jacobgkhuynh-stack/D67/README.md

# Diodeless-Keyboard with 67 keys in a 65% layout
So here's what this is, a Diodeless Keyboard that uses graph theory like Triliu's JESK56 keyboard https://github.com/triliu/JESK56 but using a different graph https://houseofgraphs.org/graphs/49999.
The nodes are pins and the vertices of the graph are switches using this method and placing them in a way can make it so that practically when using the board it feels like a n-key-rollover board even though it' actually only 4-key-rollover
I made this for week 5 of Hack Club's Halflife program.
I have no clue if it works but it took a ton of time.
Oh yeah, you can replace the 2 keys near the bottom right with a oled display if you wanted




Here's a BoM
|Item |Qty|Supplier |Cost/item|Total Cost|link |
|---|---|---|---|---|---|
|PCB |1  |JLCPCB |$12.60 |$12.60 |https://jlcpcb.com/ |
|Keyboard Switches 70 pcs|1  |uluky Lifestyle Store Store|$20.94 |$20.94 |https://www.aliexpress.us/item/3256804099108371.html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|
|RP2350B devboard |1  |Raysunny Store |$8.85 |$8.85 |https://www.aliexpress.us/item/3256813259480447.html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 |
|Estimated total shipping|1  | | |$20.02 | |
