jacobgkhuynh-stack/D67/D67/PCB_KiCad/production/bom.csv

Designator | Footprint | Quantity | Value | LCSC Part #
J1 | PinHeader_1x04_P2.54mm_Vertical | 1 | Conn_01x04_Pin
SW1, SW10, SW11, SW12, SW13, SW14, SW15, SW16, SW17, SW18, SW19, SW2, SW20, SW21, SW22, SW23, SW24, SW25, SW28, SW29, SW3, SW30, SW31, SW32, SW33, SW34, SW35, SW36, SW37, SW38, SW39, SW4, SW40, SW42, SW43, SW44, SW45, SW46, SW47, SW48, SW52, SW55, SW56, SW57, SW58, SW59, SW60, SW61, SW62, SW64, SW65, SW8, SW9 | SW_Cherry_MX_1.00u_PCB | 53 | SW_Push_45deg
SW26 | SW_Cherry_MX_2.00u_PCB | 1 | SW_Push_45deg
SW27, SW50, SW51, SW53, SW54 | SW_Cherry_MX_1.25u_PCB | 5 | SW_Push_45deg
SW41, SW7 | SW_Cherry_MX_2.25u_PCB | 2 | SW_Push_45deg
SW49, SW5 | SW_Cherry_MX_1.50u_PCB | 2 | SW_Push_45deg
SW6, SW63 | SW_Cherry_MX_1.75u_PCB | 2 | SW_Push_45deg
SW66 | SW_Cherry_MX_6.25u_PCB | 1 | SW_Push_45deg
SW67 | RotaryEncoder_Alps_EC11E-Switch_Vertical_H20mm | 1 | RotaryEncoder_Switch_MP
U1 | Raspberry-Pi-Pico-2-RP2350-Linux-MINI-RP2350B-USB | 1 | ~
