jacobgkhuynh-stack/D67/D67/PCB_KiCad/DiodelessKeyboard.kicad_pcb

## KiCad design D67/PCB_KiCad/DiodelessKeyboard.kicad_pcb (2026-11-09)

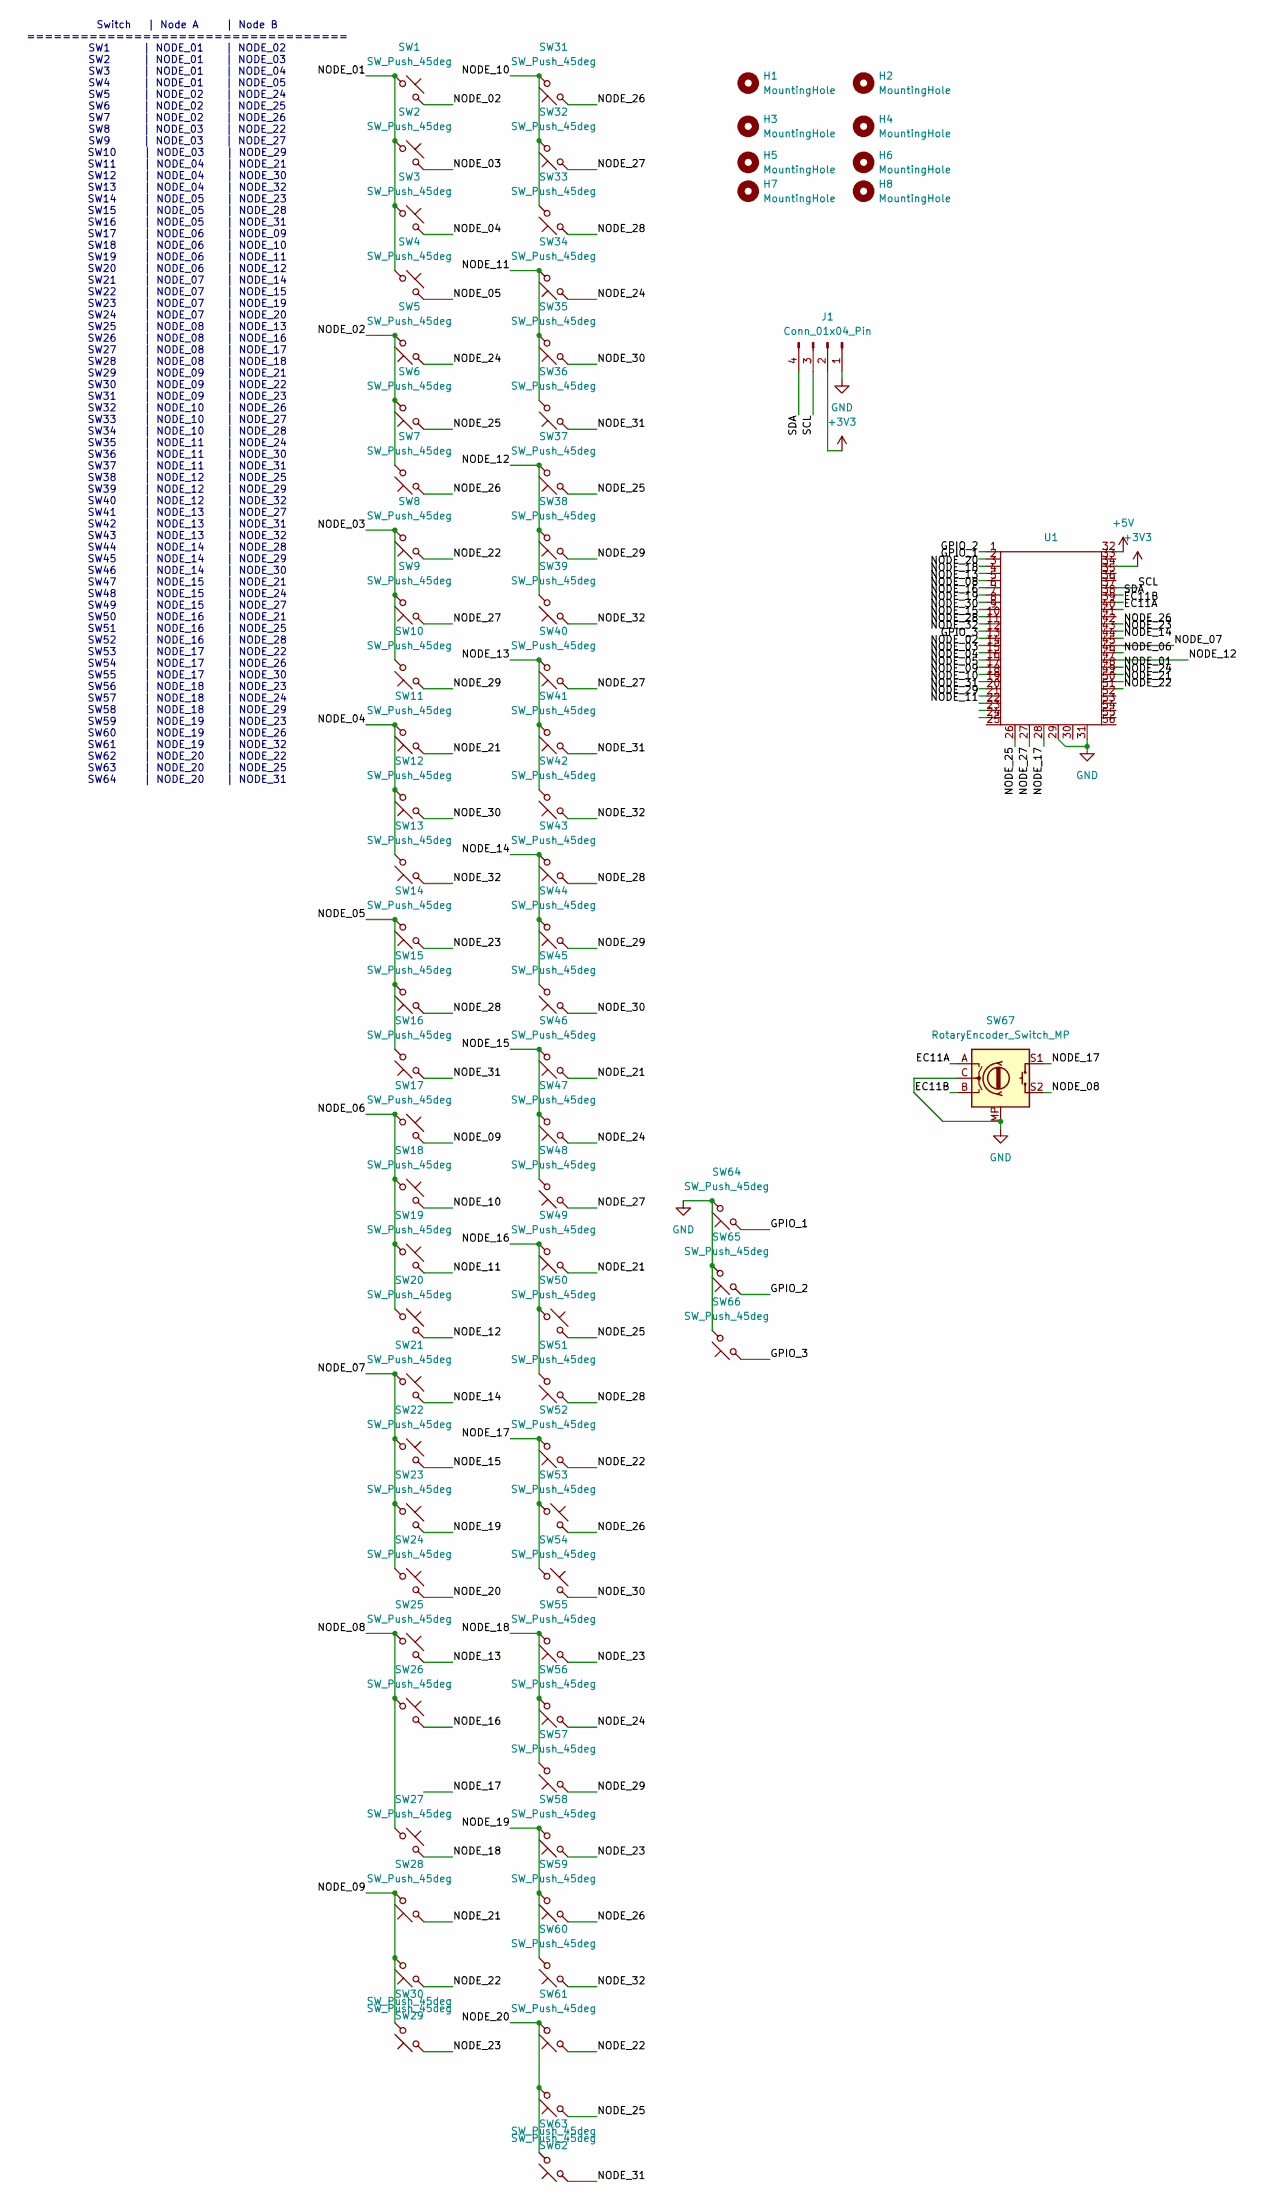
[picture p1: schematic DiodelessKeyboard.kicad_sch]

Parts:
H1, H2, H3, H4, H5, H6, H7, H8: MountingHole; MountingHole_2.7mm_M2.5
J1: Conn_01x04_Pin; PinHeader_1x04_P2.54mm_Vertical
SW1, SW2, SW3, SW4, SW8, SW9, SW10, SW11, SW12, SW13, SW14, SW15, SW16, SW17, SW18, SW19, SW20, SW21, SW22, SW23, SW24, SW25, SW28, SW29, SW30, SW31, SW32, SW33, SW34, SW35, SW36, SW37, SW38, SW39, SW40, SW42, SW43, SW44, SW45, SW46, SW47, SW48, SW52, SW55, SW56, SW57, SW58, SW59, SW60, SW61, SW62, SW64, SW65: SW_Push_45deg; SW_Cherry_MX_1.00u_PCB
SW5, SW49: SW_Push_45deg; SW_Cherry_MX_1.50u_PCB
SW6, SW63: SW_Push_45deg; SW_Cherry_MX_1.75u_PCB
SW7, SW41: SW_Push_45deg; SW_Cherry_MX_2.25u_PCB
SW26: SW_Push_45deg; SW_Cherry_MX_2.00u_PCB
SW27, SW50, SW51, SW53, SW54: SW_Push_45deg; SW_Cherry_MX_1.25u_PCB
SW66: SW_Push_45deg; SW_Cherry_MX_6.25u_PCB
SW67: RotaryEncoder_Switch_MP; RotaryEncoder_Alps_EC11E-Switch_Vertical_H20mm
U1: Raspberry-Pi-Pico-2-RP2350-Linux-MINI-RP2350B-USB

Connections:
+3V3: J1.2, U1.34
+5V: U1.32
/EC11A: SW67.A, U1.40
/EC11B: SW67.B, U1.39
/GPIO_1: SW64.1, U1.2
/GPIO_2: SW65.1, U1.1
/GPIO_3: SW66.1, U1.13
/NODE_01: SW1.1, SW2.1, SW3.1, SW4.1, U1.48
/NODE_02: SW1.2, SW5.2, SW6.2, SW7.2, U1.14
/NODE_03: SW2.2, SW8.2, SW9.2, SW10.2, U1.15
/NODE_04: SW3.2, SW11.2, SW12.2, SW13.2, U1.16
/NODE_05: SW4.2, SW14.2, SW15.2, SW16.2, U1.17
/NODE_06: SW17.1, SW18.1, SW19.1, SW20.1, U1.46
/NODE_07: SW21.1, SW22.1, SW23.1, SW24.1, U1.45
/NODE_08: SW25.1, SW26.1, SW27.1, SW67.S2, U1.6
/NODE_09: SW17.2, SW28.2, SW29.2, SW30.2, U1.18
/NODE_10: SW18.2, SW31.2, SW32.2, SW33.2, U1.19
/NODE_11: SW19.2, SW34.2, SW35.2, SW36.2, U1.22
/NODE_12: SW20.2, SW37.2, SW38.2, SW39.2, U1.47
/NODE_13: SW25.2, SW40.2, SW41.2, SW42.2, U1.5
/NODE_14: SW21.2, SW43.2, SW44.2, SW45.2, U1.44
/NODE_15: SW22.2, SW46.2, SW47.2, SW48.2, U1.10
/NODE_16: SW26.2, SW49.2, SW50.1, SW51.2, U1.7
/NODE_17: SW52.2, SW53.1, SW54.1, SW67.S1, U1.28
/NODE_18: SW27.2, SW55.2, SW56.2, SW57.2, U1.4
/NODE_19: SW23.2, SW58.2, SW59.2, SW60.2, U1.8
/NODE_20: SW24.2, SW61.2, SW62.2, SW63.2, U1.3
/NODE_21: SW11.1, SW28.1, SW46.1, SW49.1, U1.50
/NODE_22: SW8.1, SW29.1, SW52.1, SW61.1, U1.51
/NODE_23: SW14.1, SW30.1, SW55.1, SW58.1, U1.43
/NODE_24: SW5.1, SW34.1, SW47.1, SW56.1, U1.49
/NODE_25: SW6.1, SW37.1, SW50.2, SW62.1, U1.26
/NODE_26: SW7.1, SW31.1, SW53.2, SW59.1, U1.42
/NODE_27: SW9.1, SW32.1, SW40.1, SW48.1, U1.27
/NODE_28: SW15.1, SW33.1, SW43.1, SW51.1, U1.11
/NODE_29: SW10.1, SW38.1, SW44.1, SW57.1, U1.21
/NODE_30: SW12.1, SW35.1, SW45.1, SW54.2, U1.9
/NODE_31: SW16.1, SW36.1, SW41.1, SW63.1, U1.20
/NODE_32: SW13.1, SW39.1, SW42.1, SW60.1, U1.12
/SCL: J1.3, U1.37
/SDA: J1.4, U1.38
GND: J1.1, SW64.2, SW65.2, SW66.2, SW67.C, SW67.MP, U1.29, U1.31

Notes on the sheet:
Switch | Node A | Node B ==================================== SW1 | NODE_01 | NODE_02 SW2 | NODE_01 | NODE_03 SW3 | NODE_01 | NODE_04 SW4 | NODE_01 | NODE_05 SW5 | NODE_02 | NODE_24 SW6 | NODE_02 | NODE_25 SW7 | NODE_02 | NODE_26 SW8 | NODE_03 | NODE_22 SW9 | NODE_03 | NODE_27 SW10 | NODE_03 | NODE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

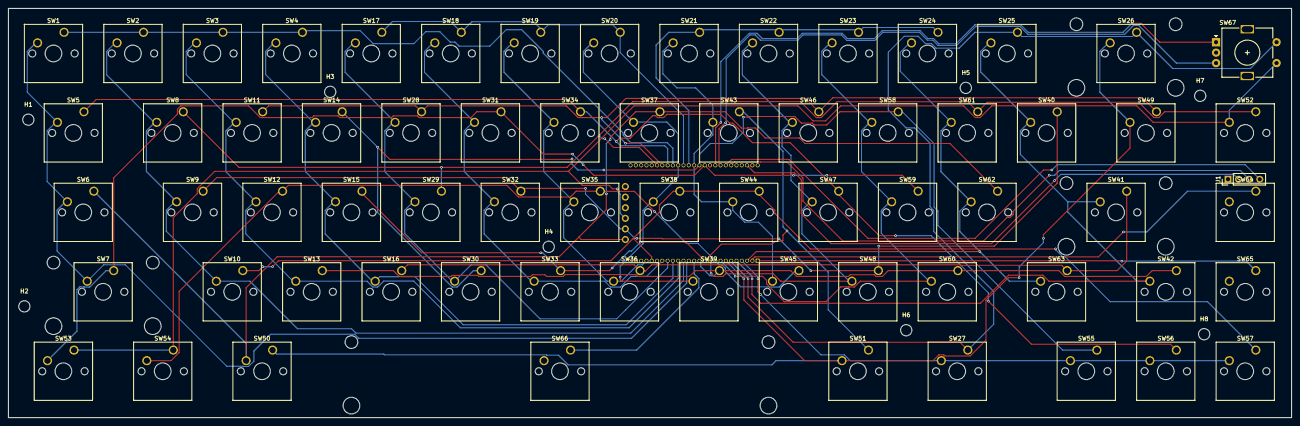
[picture p2: board DiodelessKeyboard.kicad_pcb from above]

Board: 2 copper layers, 307.7 x 98.1 mm, 77 parts (1 on the bottom side), 41 nets.
