jacobgkhuynh-stack/D67/JOURNAL.md

# D67: devlog

<!-- Generated by Half Life from project sct16psqbwh7u2go61ao3h23. Edits here are overwritten on the next sync. -->
<!-- Generated: 2026-11-08T23:26:14.269Z -->

> [!NOTE]
> This devlog is mirrored from [Half Life](https://halflife.hackclub.com) ([open the project](https://halflife.hackclub.com/projects/sct16psqbwh7u2go61ao3h23)). Editing it here will not change the platform's copy, and the next sync overwrites this file.

> So here's what this is, a Diodeless Keyboard that uses graph theory like Triliu's JESK56 keyboard https://github.com/triliu/JESK56 but using a different graph https://houseofgraphs.org/graphs/49999. The nodes are pins and the vertices of the graph are switches using this method and placing them in a way can make it so that practically when using the board it feels like a n-key-rollover board even though it' actually only 4-key-rollover I made this for week 5 of Hack Club's Halflife program. I have no clue if it works but it took a ton of time. Oh yeah, you can replace the 2 keys near the bottom right with a oled display if you wanted

| Week | Tier | Hours logged | Entries |
| --- | --- | --- | --- |
| Week 5 | Tier 2 | 16.56h | 3 |

## Contents

1. [2026-11-08: Work session](#2026-11-08-work-session)
2. [2026-11-08: Work session](#2026-11-08-work-session)
3. [2026-11-08: Worked on routing my pcb and finished it.](#2026-11-08-worked-on-routing-my-pcb-and-finished-it)

## Design

### 2026-11-08: Work session

**6.98h**

[Timelapse](https://lookout.hackclub.com/api/media/24ddd955-1ba2-4e50-900d-ef4eddf3f24e/video.mp4)

[Timelapse](https://lookout.hackclub.com/api/media/b2d26e65-544e-41b2-8971-642fcdb0f239/video.mp4)

[Timelapse](https://lookout.hackclub.com/api/media/360c909c-3d4b-4ed8-abcf-9968c5d8d61f/video.mp4)

[Timelapse](https://lookout.hackclub.com/api/media/9d00fdcf-8325-44f1-9bcb-454b382604b7/video.mp4)

[Timelapse](https://lookout.hackclub.com/api/media/d350496a-1156-4e83-bd57-01b841803253/video.mp4)

### 2026-11-08: Work session

**2.08h**

[Timelapse](https://lookout.hackclub.com/api/media/d167a515-14dc-4ece-98a8-601dfa053801/video.mp4)

### 2026-11-08: Worked on routing my pcb and finished it.

**7.5h**

Worked on routing my pcb and finished it.

Made custom symbol and footprint for my devboard I found online(I know they look pretty bad)





Needed to remove Leds to complete routing on time. I had alot of trouble routing this unconventional matrix style for my diodeless design.








Ran DRC to confirm any issues.
I got errors about disconnected ground plane islands
Used vias to remove the gap between islands.
 Ran DRC to confirm any issues again
Dismissed one final error about courtyard collisions between parts which were optional like add ins. Like you could solder in a display or instead two switches.



idk why my timelapse didn't compiled and failed so i needed to make this
