jacobgkhuynh-stack/D67/(commit log)

2026-11-04 Sync Keyboard without diodes from Half Life
    [BOM.csv]
2026-11-09 Add config.h for diodeless67 keyboard layout
2026-11-09 Add diodeless67 keymap header file
2026-11-09 Remove diodeless67.h file
2026-11-09 Add keymap configuration for diodeless67 keyboard
2026-11-09 Add info.json for Diodeless67 keyboard
2026-11-09 Add initial Vial configuration for Diodeless67 keyboard
2026-11-09 Enhance README with project details and images
    Expanded the README to include details about the Diodeless Keyboard's design, functionality, and images.
2026-11-09 Sync D67 from Half Life
    [BOM.csv]
